pasicl/Ultrasound-flowmeter/Hardware/TX_RX_switch_MAX333_final.brd

## EAGLE design Hardware/TX_RX_switch_MAX333_final.brd (2023-06-26)

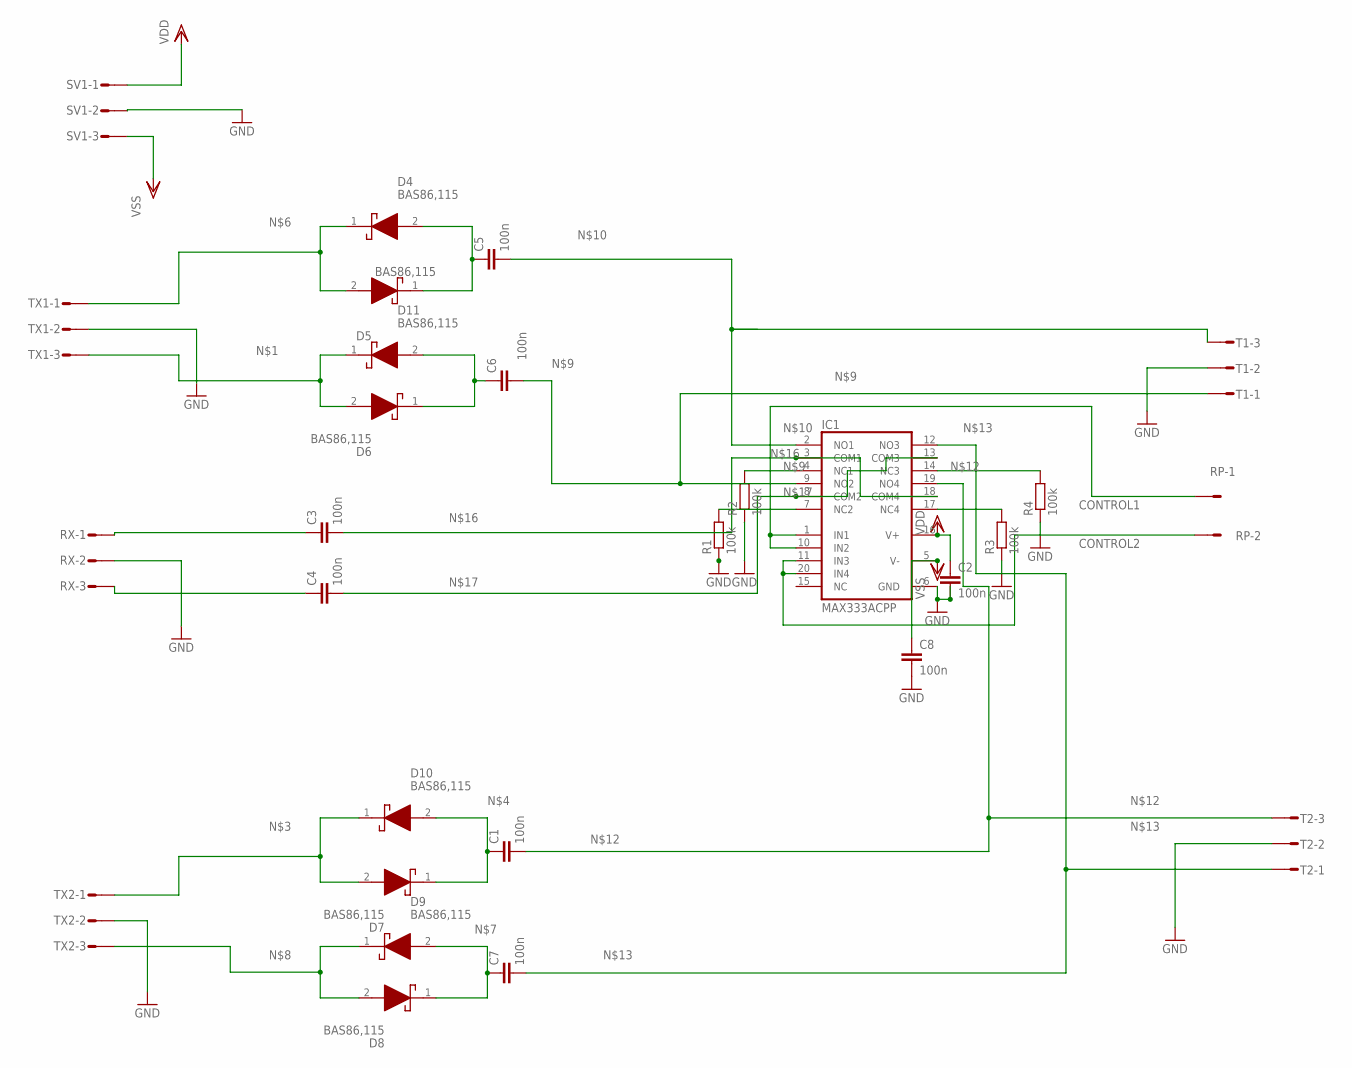
[picture p45: schematic TX_RX_switch_MAX333_final.sch]

Parts:
C1, C2, C3, C4, C5, C6, C7, C8: 100n; C1206
D4, D5, D6, D7, D8, D9, D10, D11: BAS86,115; BAS86115
IC1: MAX333ACPP; DIL20
R1, R2, R3, R4: 100k; R1206
RP: L02P
RX: L03P
SV1: L03P
T1, T2: L03P
TX1, TX2: L03P

Connections:
CONTROL1: IC1.1 (IN1), IC1.10 (IN2), RP.1
CONTROL2: IC1.11 (IN3), IC1.20 (IN4), RP.2
GND: C2.2, C8.2, IC1.6 (GND), R1.1, R2.1, R3.1, R4.1
GND3: RX.2, SV1.2, T1.2, T2.2, TX1.2, TX2.2
unnamed: D6.2 (A), D11.1 (K), TX1.3
unnamed: C6.1, D6.1 (K), D11.2 (A)
unnamed: D7.2 (A), D10.1 (K), TX2.1
unnamed: C1.1, D7.1 (K), D10.2 (A)
unnamed: C5.1, D4.2 (A), D5.1 (K)
unnamed: D4.1 (K), D5.2 (A), TX1.1
unnamed: C7.1, D8.1 (K), D9.2 (A)
unnamed: D8.2 (A), D9.1 (K), TX2.3
unnamed: C6.2, IC1.9 (NO2), T1.1
unnamed: C5.2, IC1.2 (NO1), T1.3
unnamed: C1.2, IC1.19 (NO4), T2.3
unnamed: C7.2, IC1.12 (NO3), T2.1
unnamed: IC1.7 (NC2), R1.2
unnamed: C4.1, RX.3
unnamed: C3.2, IC1.3 (COM1), IC1.18 (COM4)
unnamed: C4.2, IC1.8 (COM2), IC1.13 (COM3)
unnamed: C3.1, RX.1
unnamed: IC1.4 (NC1), R2.2
unnamed: IC1.14 (NC3), R4.2
unnamed: IC1.17 (NC4), R3.2
VDD: C2.1, IC1.16 (V+), SV1.1
VSS: C8.1, IC1.5 (V-), SV1.3

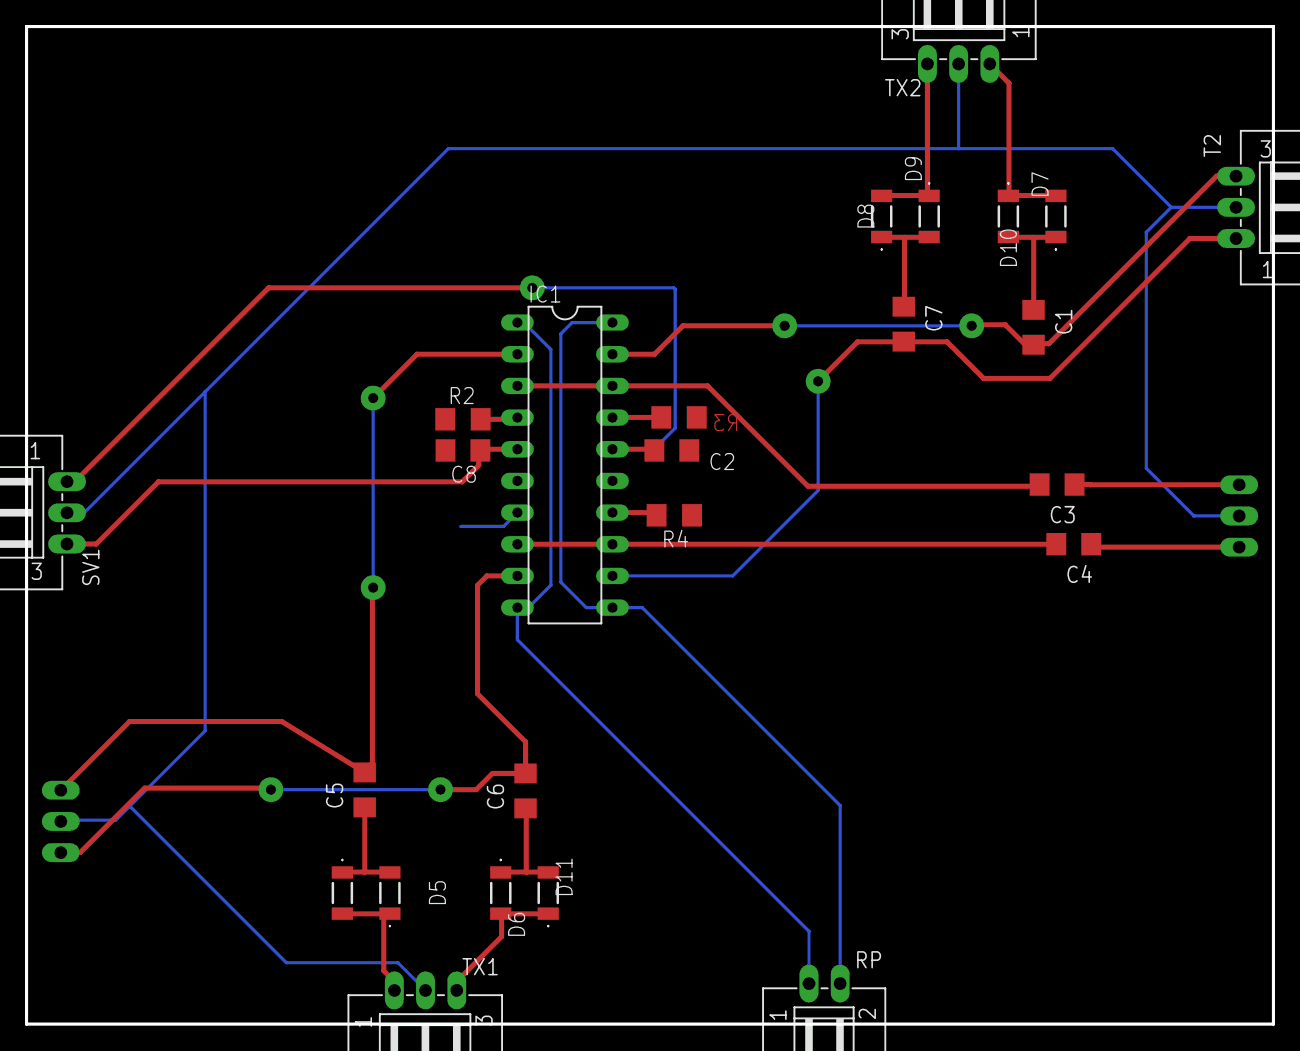
[picture p46: board TX_RX_switch_MAX333_final.brd from above]

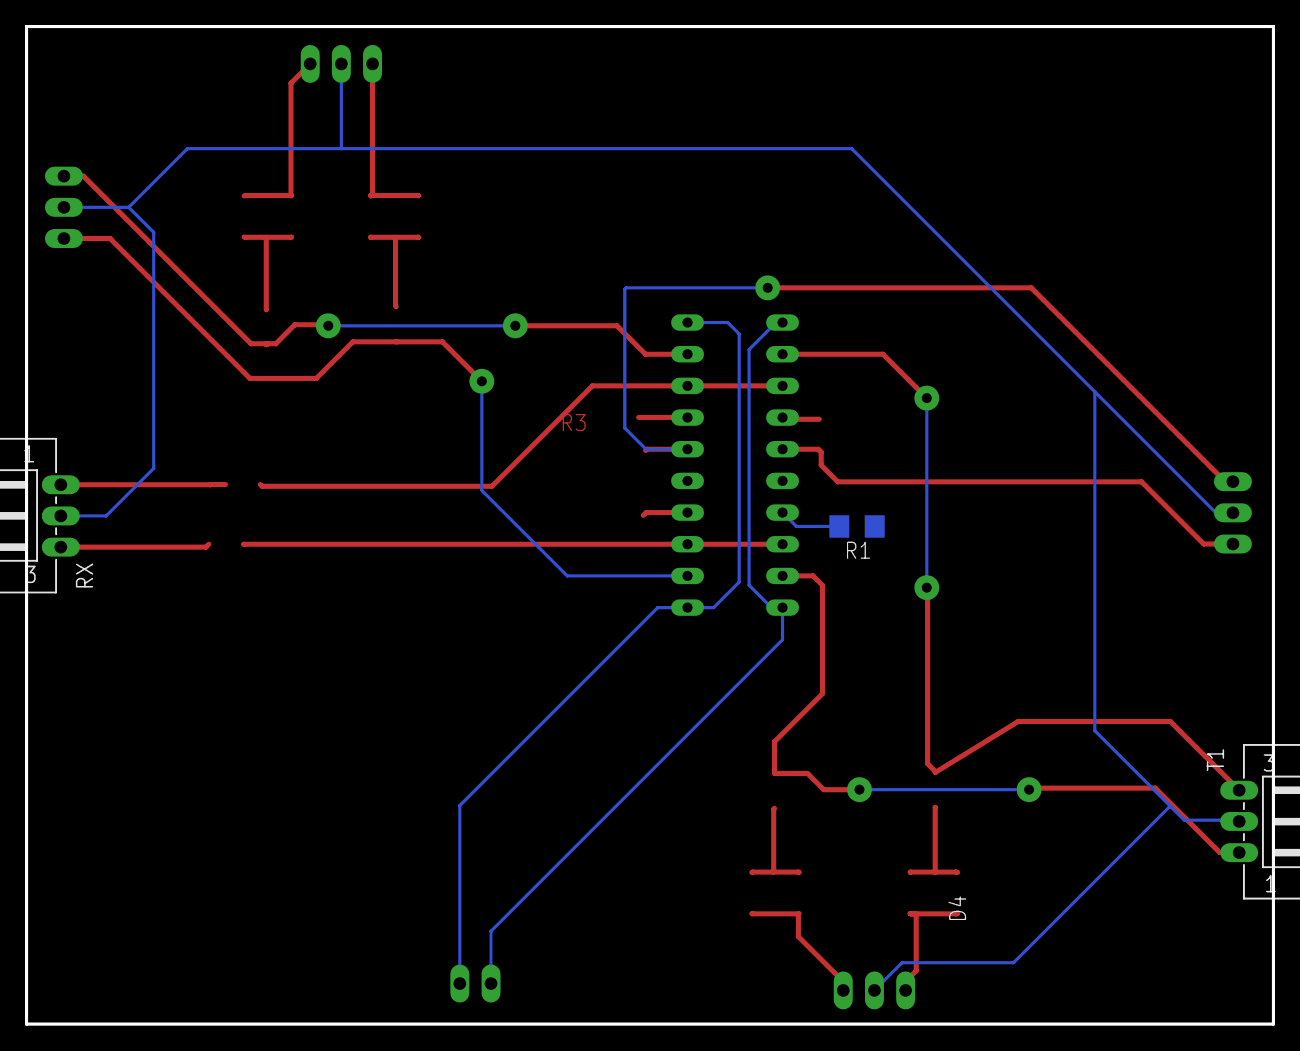
[picture p47: board TX_RX_switch_MAX333_final.brd from below]

Board: 2 copper layers, 100.0 x 80.0 mm, 28 parts (3 on the bottom side), 26 nets.
